ClubmakerCanFabra/casa_domotica/disseny_maqueta_casa/Distribució_Dispositius_Domotics_Casa.JPG

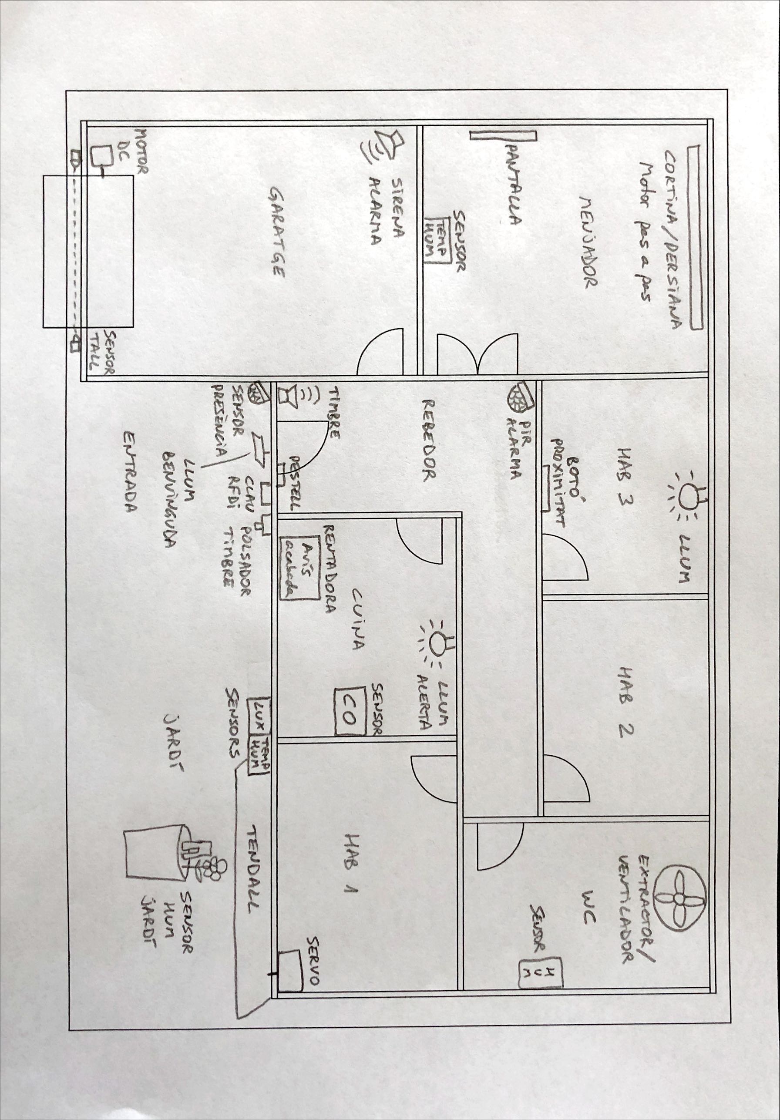
disseny_maqueta_casa/Distribució_Dispositius_Domotics_Casa.JPG
