ClubmakerCanFabra/casa_domotica/README.md

# casa_domotica
Casa domòtica amb Home Assistant Cursos 2022-2023, 2023-2024 i 2024-2025
American Space Club Maker Biblioteca Can Fabra
