ClubmakerCanFabra/casa_domotica/disseny_maqueta_casa/Electrònica/BME280 + Pantalla Oled.jpg

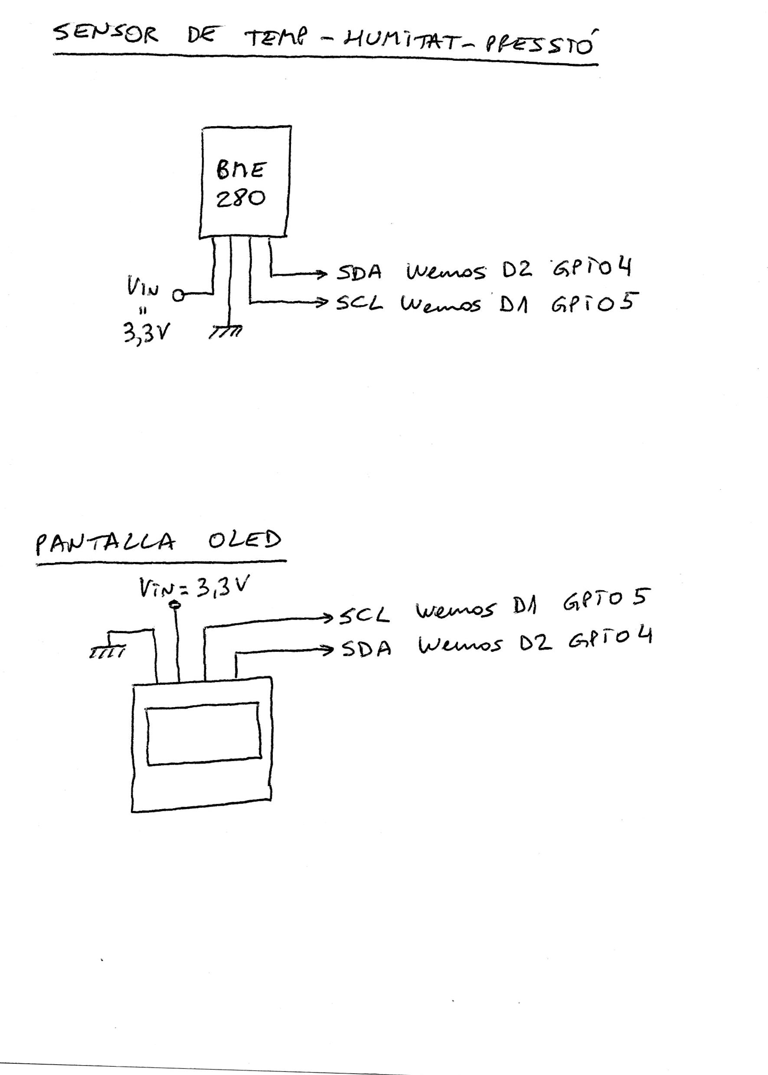
disseny_maqueta_casa/Electrònica/BME280 + Pantalla Oled.jpg
