ClubmakerCanFabra/casa_domotica/disseny_maqueta_casa/Electrònica/DHT.jpg

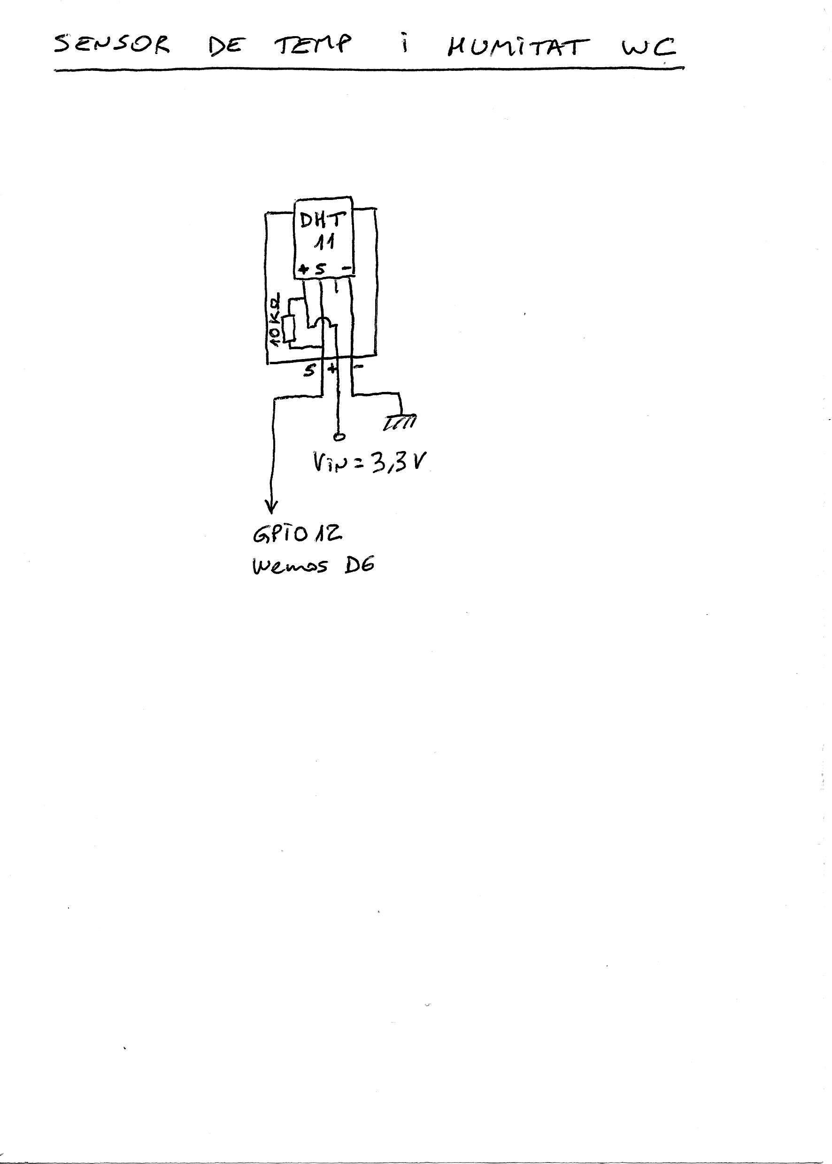
disseny_maqueta_casa/Electrònica/DHT.jpg
