ClubmakerCanFabra/casa_domotica/disseny_maqueta_casa/Electrònica/Llum + SensorCO + MesuraCorrent Cuina.jpg

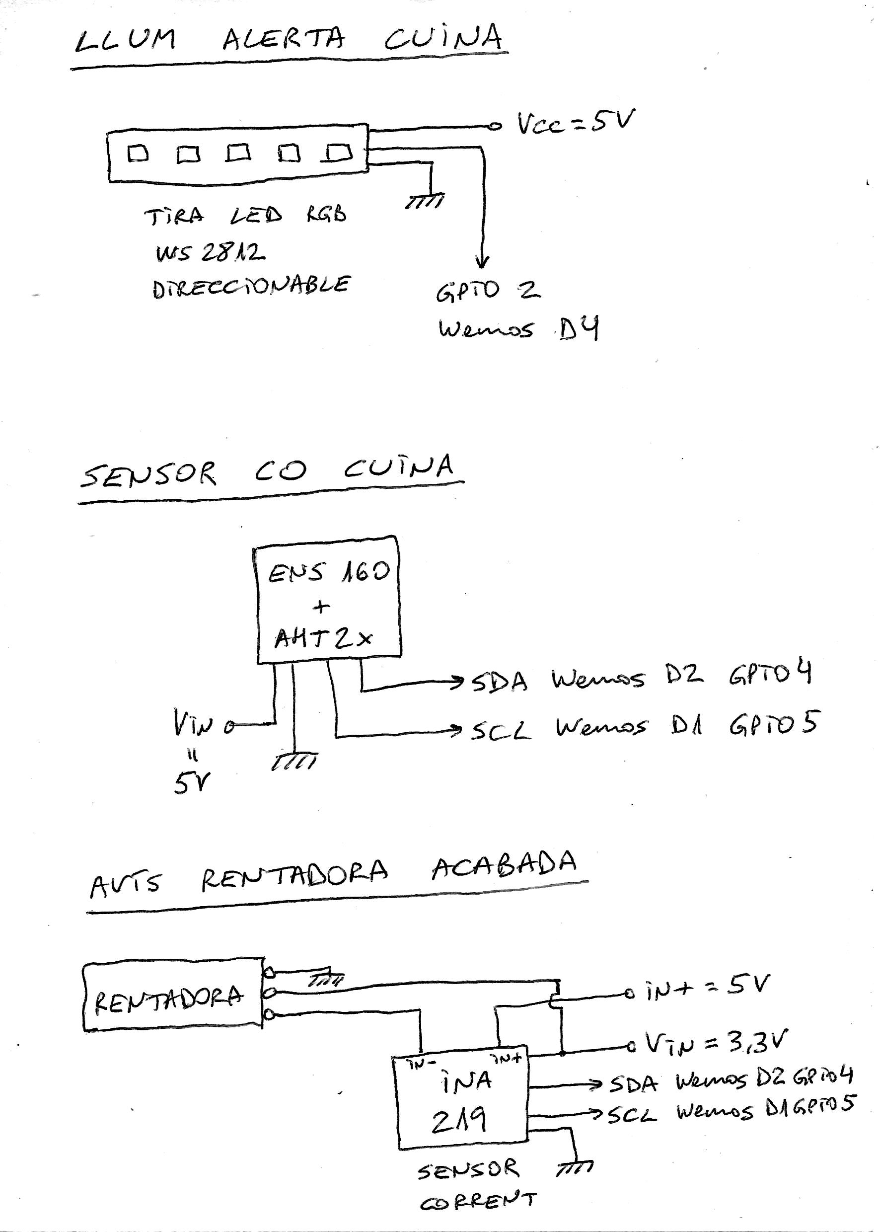
disseny_maqueta_casa/Electrònica/Llum + SensorCO + MesuraCorrent Cuina.jpg
