ClubmakerCanFabra/casa_domotica/disseny_maqueta_casa/Electrònica/Llum Habitació.jpg

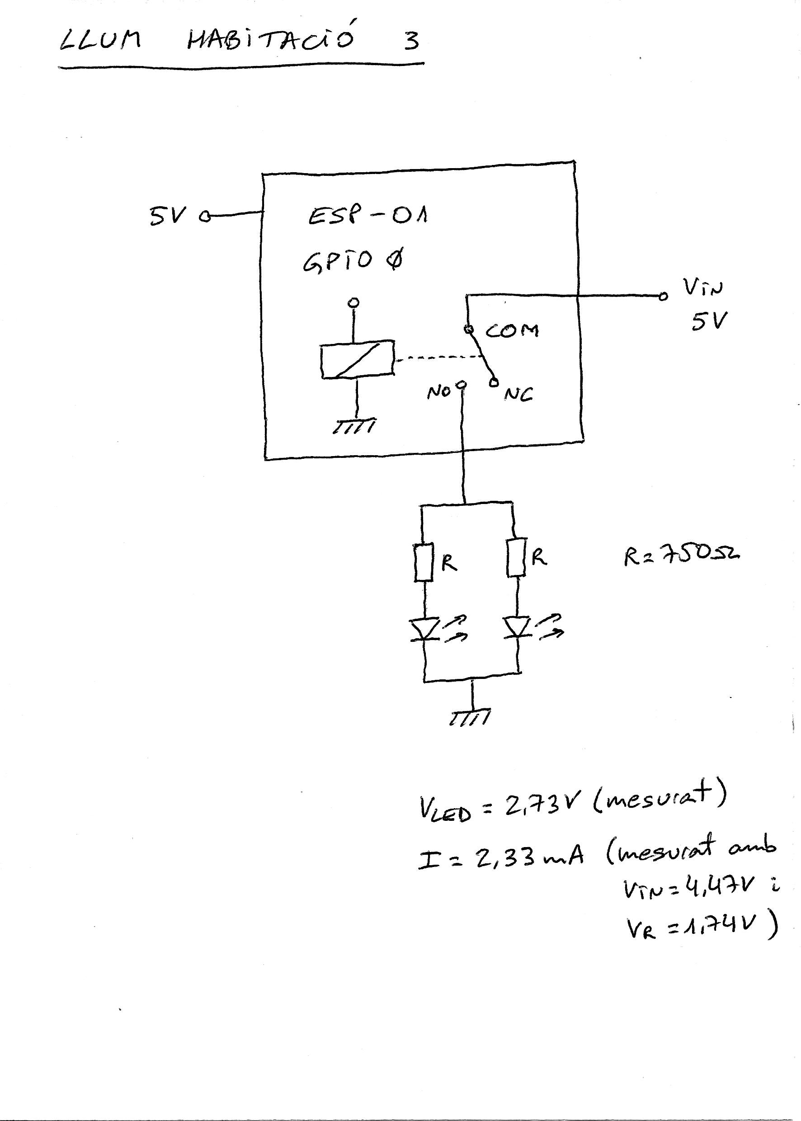
disseny_maqueta_casa/Electrònica/Llum Habitació.jpg
