ClubmakerCanFabra/casa_domotica/disseny_maqueta_casa/Electrònica/Rentadora.jpg

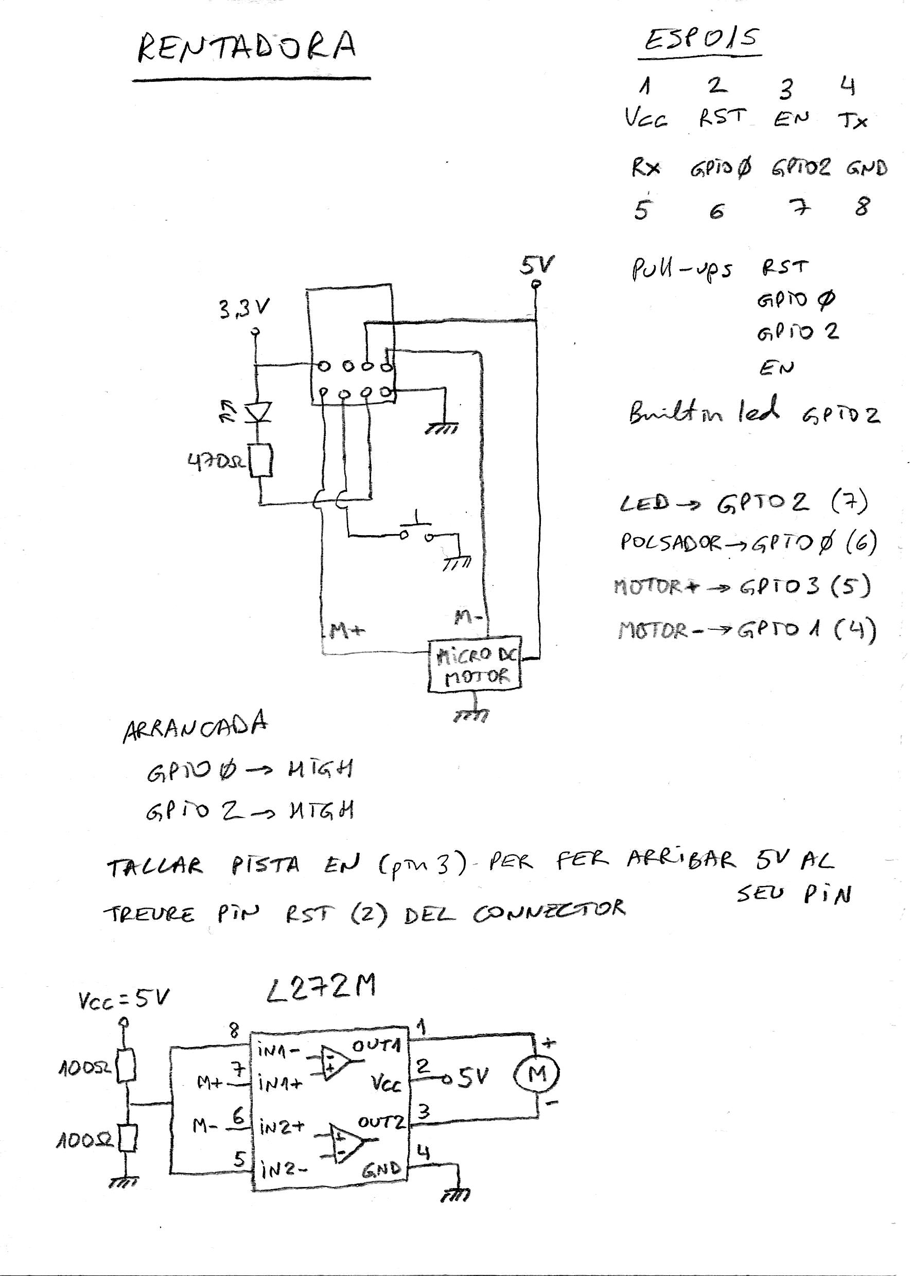
disseny_maqueta_casa/Electrònica/Rentadora.jpg
