ClubmakerCanFabra/casa_domotica/disseny_maqueta_casa/Electrònica/RFID+Polsador+PIR+Llum+Timbre.jpg

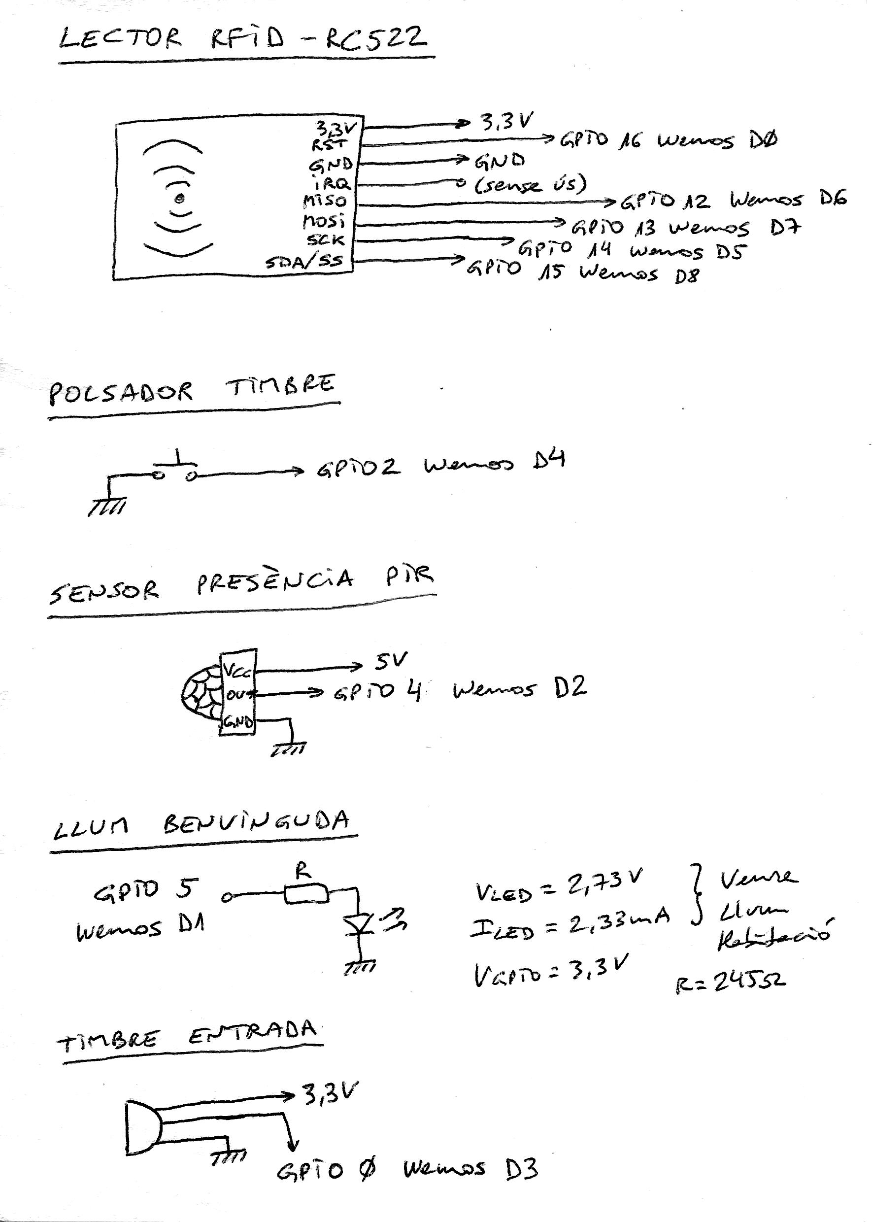
disseny_maqueta_casa/Electrònica/RFID+Polsador+PIR+Llum+Timbre.jpg
