ClubmakerCanFabra/casa_domotica/disseny_maqueta_casa/Electrònica/Sensor Tall Porta Garatge.jpg

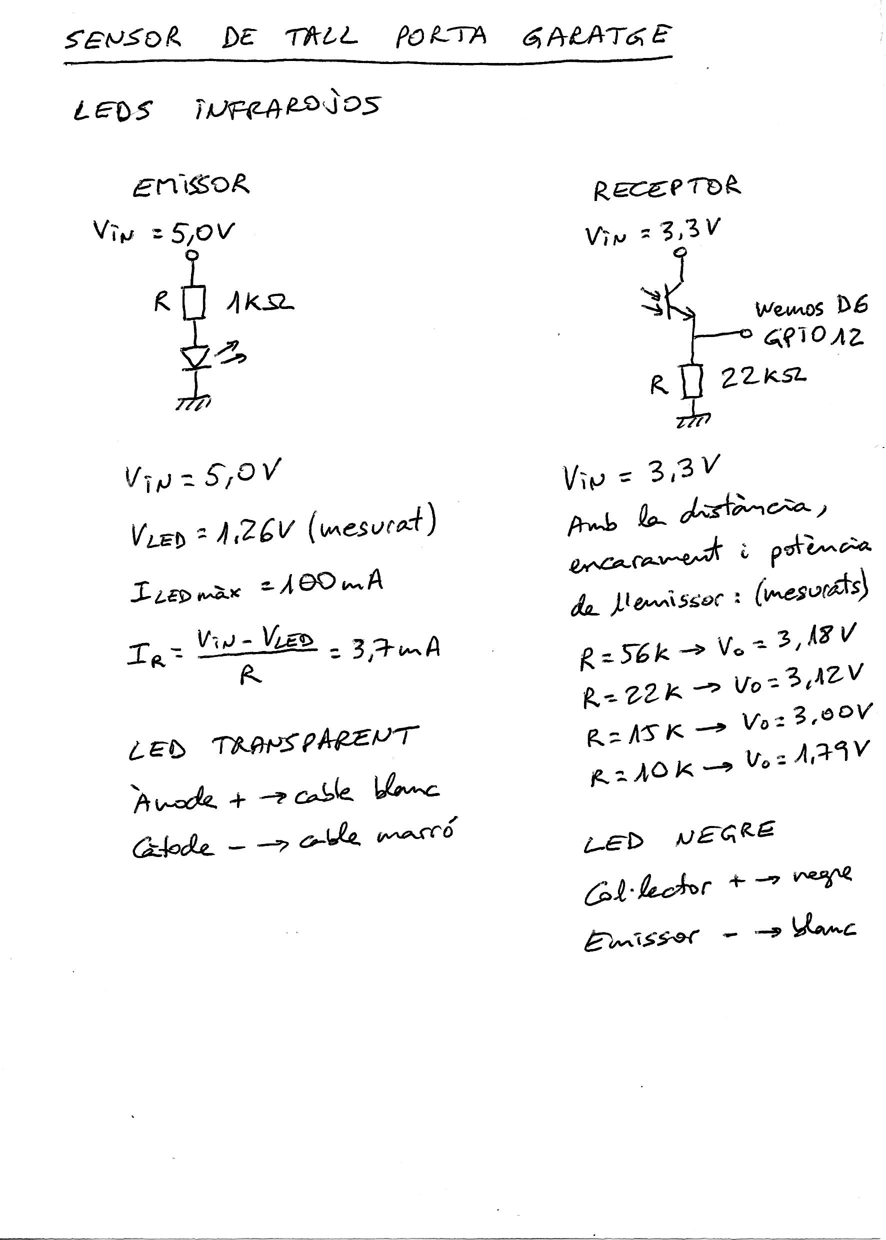
disseny_maqueta_casa/Electrònica/Sensor Tall Porta Garatge.jpg
