ClubmakerCanFabra/casa_domotica/disseny_maqueta_casa/Electrònica/Servo Porta Garatge.jpg

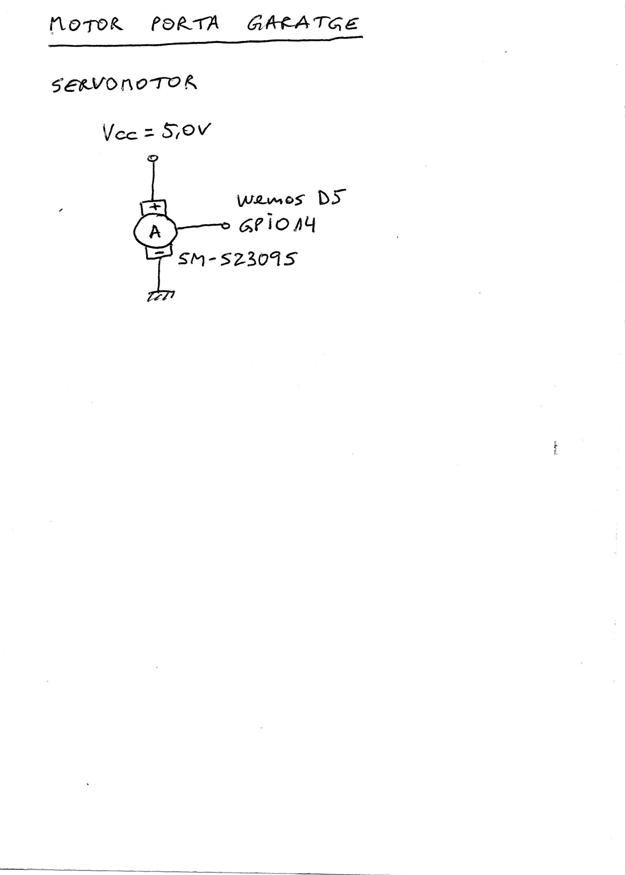
disseny_maqueta_casa/Electrònica/Servo Porta Garatge.jpg
