ClubmakerCanFabra/casa_domotica/disseny_maqueta_casa/Electrònica/Ventilador WC.jpg

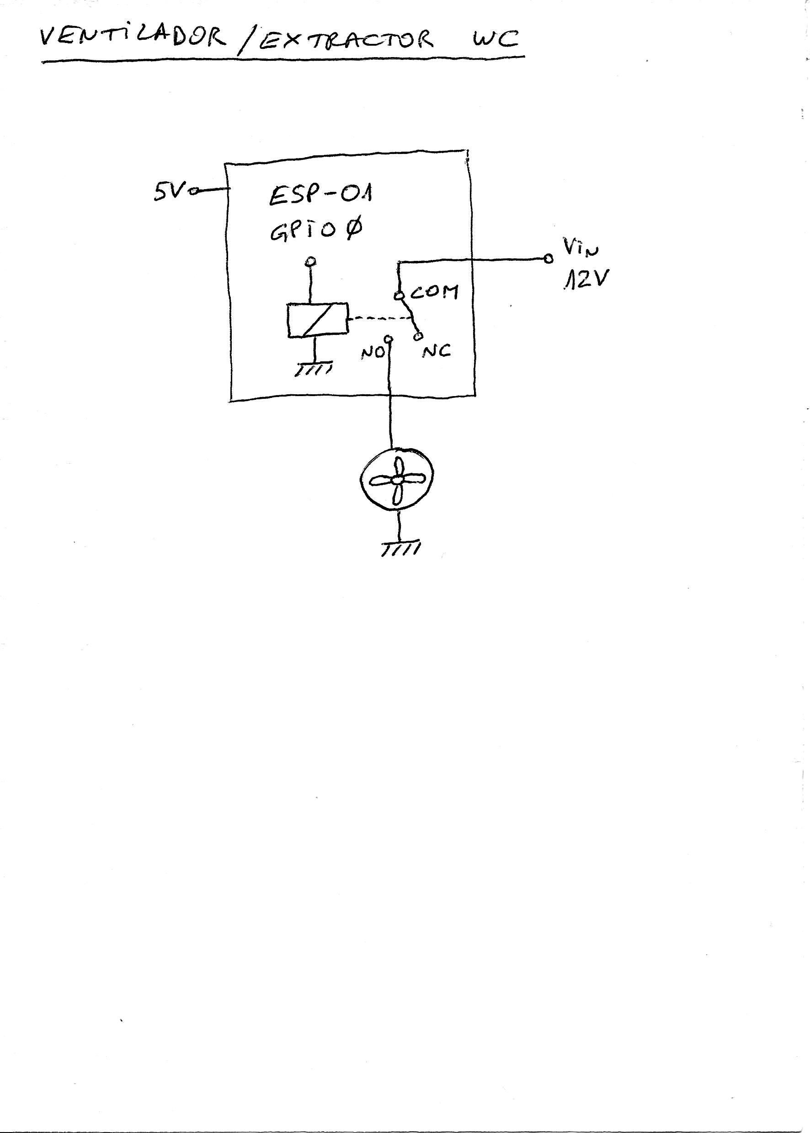
disseny_maqueta_casa/Electrònica/Ventilador WC.jpg
