ClubmakerCanFabra/casa_domotica/disseny_maqueta_casa/Electrònica/Voltímetre1.jpg

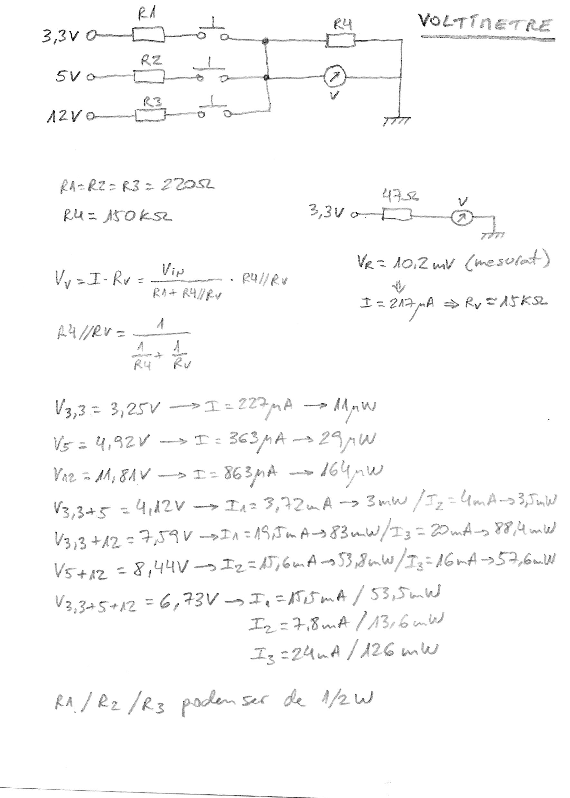
disseny_maqueta_casa/Electrònica/Voltímetre1.jpg
