ClubmakerCanFabra/casa_domotica/disseny_maqueta_casa/Electrònica/Voltímetre2.jpg

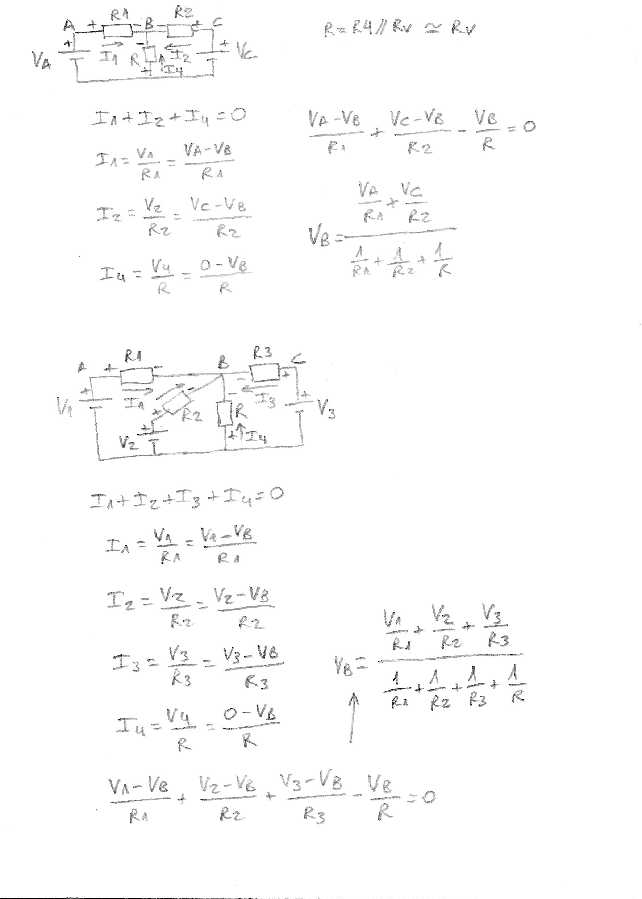
disseny_maqueta_casa/Electrònica/Voltímetre2.jpg
