ClubmakerCanFabra/casa_domotica/disseny_maqueta_casa/Elements 3D/Dissenys/Caixa ESP01 + Relé.jpg

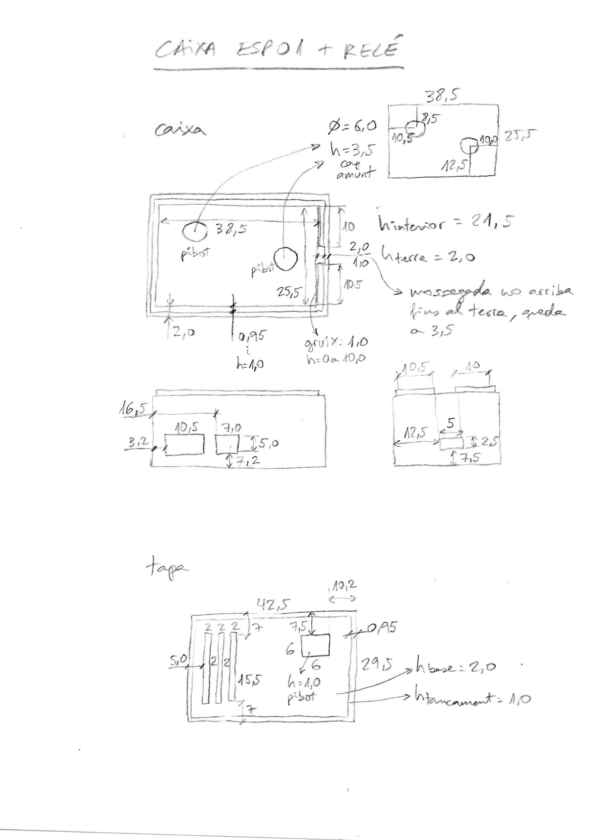
disseny_maqueta_casa/Elements 3D/Dissenys/Caixa ESP01 + Relé.jpg
