ClubmakerCanFabra/casa_domotica/disseny_maqueta_casa/Elements 3D/Dissenys/Caixa SensorCO.jpg

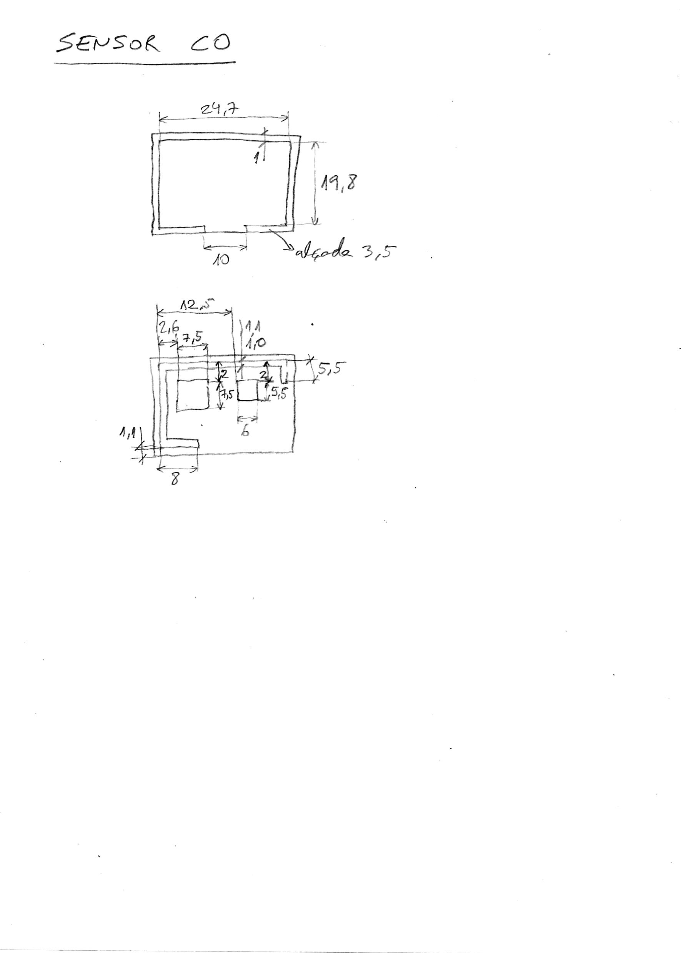
disseny_maqueta_casa/Elements 3D/Dissenys/Caixa SensorCO.jpg
