ClubmakerCanFabra/casa_domotica/disseny_maqueta_casa/Elements 3D/Dissenys/Caixa Wemos.jpg

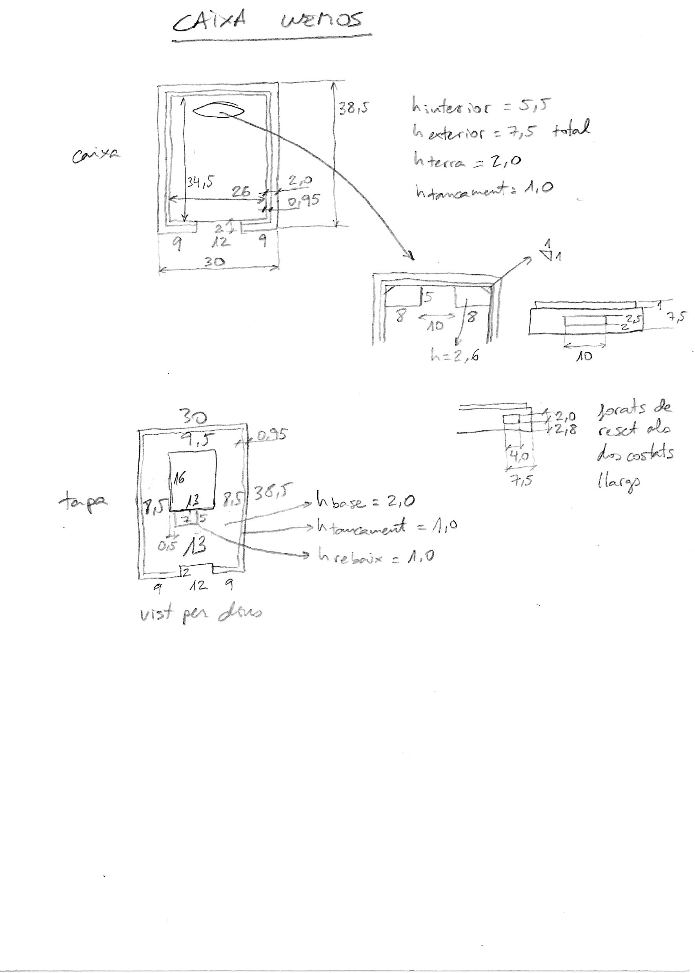
disseny_maqueta_casa/Elements 3D/Dissenys/Caixa Wemos.jpg
