ClubmakerCanFabra/casa_domotica/disseny_maqueta_casa/Elements 3D/Dissenys/Caixes BME280 + Pantalla Oled.jpg

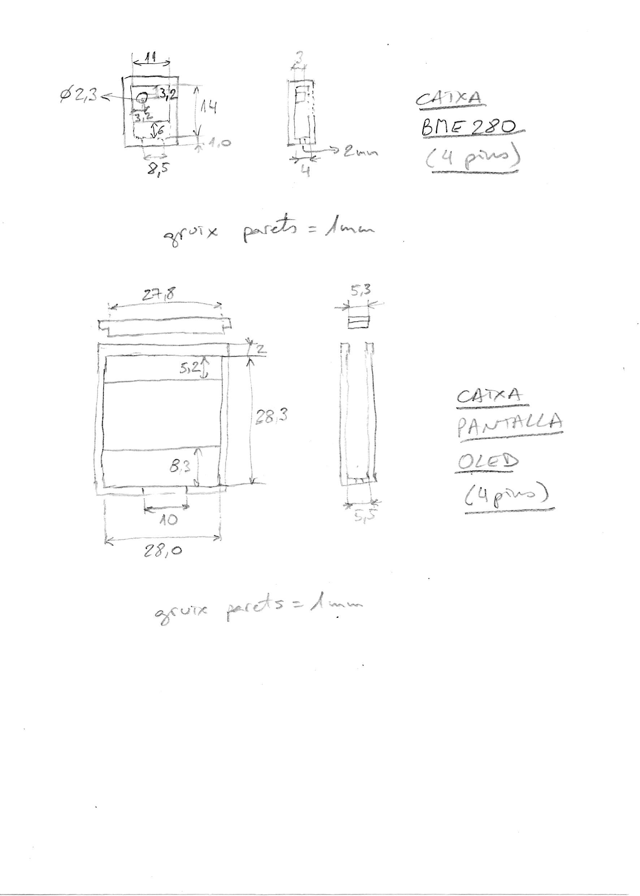
disseny_maqueta_casa/Elements 3D/Dissenys/Caixes BME280 + Pantalla Oled.jpg
