ClubmakerCanFabra/casa_domotica/disseny_maqueta_casa/Elements 3D/Dissenys/Caixes Ventilador + Col·lector.jpg

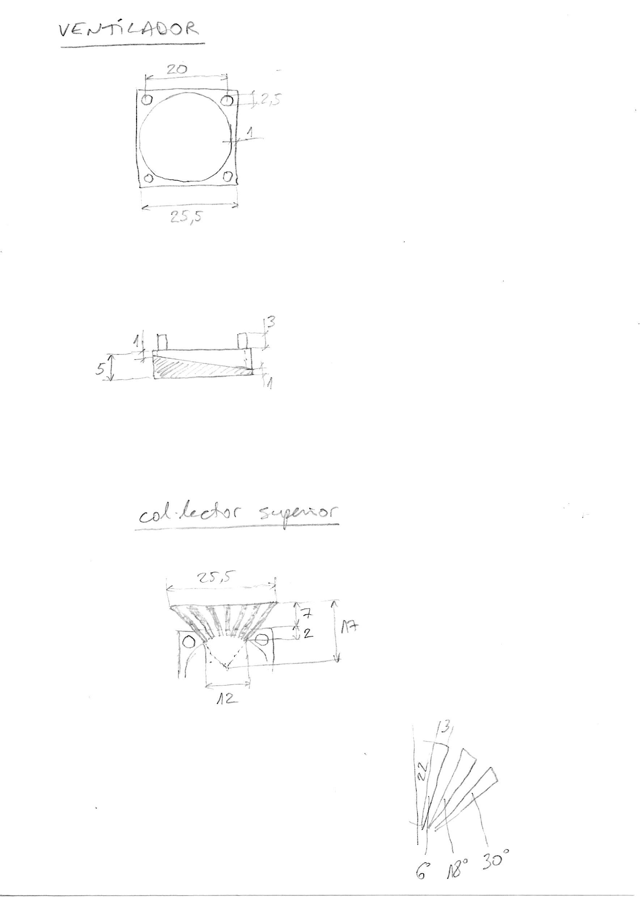
disseny_maqueta_casa/Elements 3D/Dissenys/Caixes Ventilador + Col·lector.jpg
