ClubmakerCanFabra/casa_domotica/disseny_maqueta_casa/Elements 3D/Dissenys/Ferratge Saxo Porta Pk.jpg

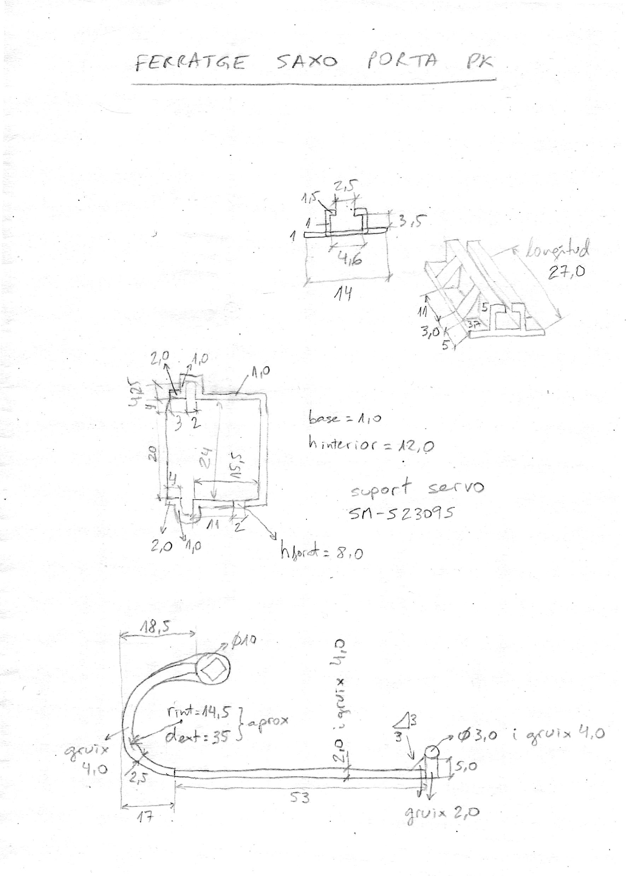
disseny_maqueta_casa/Elements 3D/Dissenys/Ferratge Saxo Porta Pk.jpg
