ClubmakerCanFabra/casa_domotica/disseny_maqueta_casa/Material_Projecte_HAss_CM.xlsx

Sheet: Material
MATERIAL PROJECTE HOME ASSISTANT CLUB MAKER
Estança | Dispositius | Material | Control |  |  | TENIM
GARATGE | Motor porta | Servo DC amb reductora | Wemos | * | 3 | Wemos | * | +6
 | Sensor tall porta | Sensor Tx-Rx infrarojos |  | * | 2 | Pir | *
 | Sirena alarma | Bronzidor | Placa relé + ESP-01 |  | 2 | bronzidor passiu | *
ENTRADA | Sensor presència | HC-SR501 | Wemos |  | 1 | pantalla | *
 | Llum benvinguda | Led blanc + R1K | Placa relé + ESP-01 |  | 1 | bme680 (qualitat aire) | *
 | Polsador timbre | Polsador | (Wemos) |  | 2 | bme280 | * | +1
 | Clau porta | Rfdi | (Wemos) |  | 1 | rfid amb clau | *
REBEDOR | Timbre entrada | Bronzidor | Placa relé + ESP-01 |  | 2 | led blanc (benvinguda) | *
 | Pestell | Servo | Placa relé + ESP-01 |  | 1 | polsador | *
 | Sensor volumètric alarma | HC-SR501 | Wemos |  | 1 | Sensor humitat jardí | *
 | Sensor magnètic porta alarma | MC-38 |  | * | 1 | servo | * | +1
MENJADOR | Motor pas a pas persiana | ULN2003 28BYJ-48 |  | * | 1 | tira neopixel | *
 | Pantalla | Oled | Wemos |  | 0 | sensor llum |  | +1
 | Sensor Temp/Hum interior | BME280 | (Wemos) |  | 0 | ventilador |  | +1
CUINA | Sensor CO | CCS811 / bme680 | Wemos |  | 0 | Placa relé + ESP-01 |  | +6
 | Llum alerta | Tira Neopíxels | (Wemos)
 | Avís Rentadora acabada
HABITACIÓ 3 | Botó proximitat | paper plata + R1M | Wemos
 | Llum | Led blanc + R1K | Placa relé + ESP-01
WC | Sensor Temp/Hum | DHT11 | Wemos | *
 | Extractor aire | Ventilador 4x4cm 5V | Placa relé + ESP-01 | *
HABITACIÓ 1 | Servo tendall | SG90
JARDÍ | Sensor Temp/Hum exterior | BME280 | Wemos
 | Sensor llum/sol | TSL2561 | (Wemos)
 | Sensor humitat jardí |  | (Wemos)

Sheet: Compres
Descripció | Link Aliexpress | Preu
WeMos D1 Mini V3.0 microUSB | https://es.aliexpress.com/item/32831353752.html?mp=1 | 1.94 €
Sensor de luz infrarroja TSL2561 | https://www.aliexpress.com/item/4000875271177.html?spm=a2g0o.cart.0.0.11b27a9dQup9MQ&mp=1 | 3.23 €
Módulo de relé ESP8266 + ESP-01 | https://es.aliexpress.com/item/32833583868.html?mp=1 | 1.84 €
Emisor y receptor IR 301A 5mm, 940nm led, 10 pares | https://es.aliexpress.com/item/32693354491.html?mp=1 | 0.61 €
Ventilador 12V 25x25mm 2510 | https://es.aliexpress.com/item/1005002448626904.html?mp=1 | 1.41 €
Luz entrada casa type1 10 unidades | https://es.aliexpress.com/item/1005003422885437.html?mp=1 | 0.98 €
Foco led 3V 12 unidades | https://es.aliexpress.com/item/1005004987442239.html?mp=1 | 3.22 €
Farola tren 10 unidades | https://es.aliexpress.com/item/4001227697309.html?mp=1 | 0.98 €

Sheet: Wemos
 |  |  | https://www.luisllamas.es/wemos-d1-mini-una-genial-placa-de-desarrollo-con-esp8266/
Pin | ESP-8266 Pin | Función
TX | TXD | TXD
RX | RXD | RXD
A0 | A0 | Analog input (max 3.2V)
D0 | GPIO16 | IO
D1 | GPIO5 | IO, PWM, Interrupt, I2C, SCL
D2 | GPIO4 | IO, PWM, Interrupt, I2C, SDA
D3 | GPIO0 | IO 10k Pull-up, PWM, Interrupt, I2C
D4 | GPIO2 | IO 10k Pull-up, PWM, Interrupt, I2C, BUILTIN_LED
D5 | GPIO14 | IO, PWM, Interrupt, I2C, SCK
D6 | GPIO12 | IO, PWM, Interrupt, I2C,, MISO
D7 | GPIO13 | IO, PWM, Interrupt, I2C,, MOSI
D8 | GPIO15 | IO 10k Pull-down, PWM, Interrupt, I2C,, SS
G | GND | Ground
5V | - | 5V
3V3 | 3.3V | 3.3V
RST | RST | Reset
