ClubmakerCanFabra/casa_domotica/disseny_maqueta_casa/Elements 3D/Stl/Caixa Wemos.stl

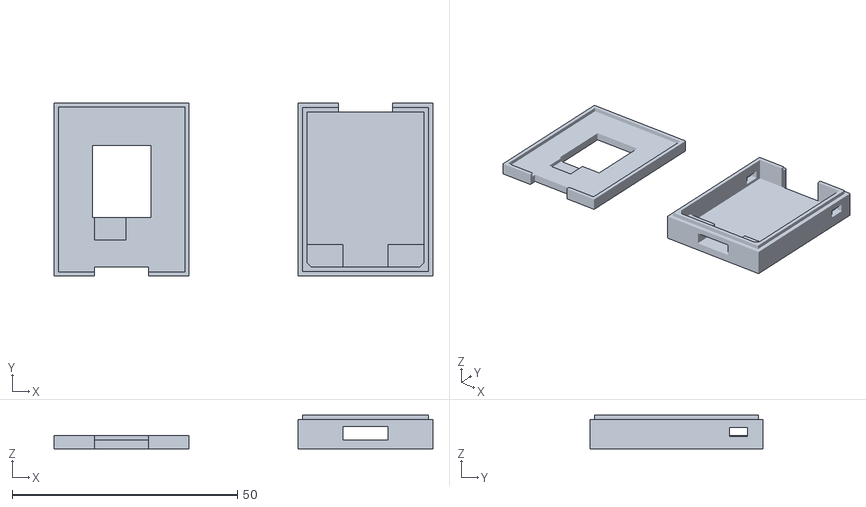
[picture p53: CAD file, 2025-03-27]
disseny_maqueta_casa/Elements 3D/Stl/Caixa Wemos.stl
84.1 x 38.5 x 7.50
