ClubmakerCanFabra/casa_domotica/disseny_maqueta_casa/Plotejat/Acad/AmericanSpace logo vectoritzat InkScape.dxf

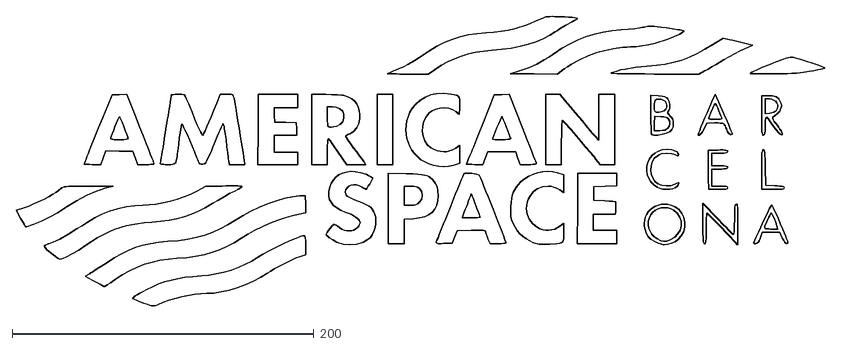
[picture p54: CAD file, 2025-03-27]
disseny_maqueta_casa/Plotejat/Acad/AmericanSpace logo vectoritzat InkScape.dxf
536.6 x 192.5
