ClubmakerCanFabra/casa_domotica/disseny_maqueta_casa/Elements 3D/Stl/Caixa Lector RFID.stl

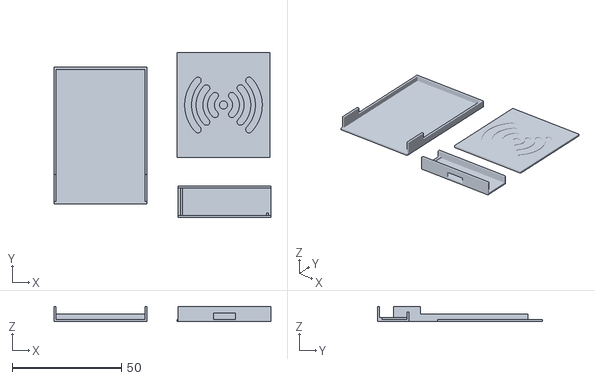
[picture p56: CAD file, 2025-03-27]
disseny_maqueta_casa/Elements 3D/Stl/Caixa Lector RFID.stl
99.2 x 75.4 x 7.00
