ClubmakerCanFabra/casa_domotica/disseny_maqueta_casa/Elements 3D/Stl/Caixa Polsador Timbre.stl

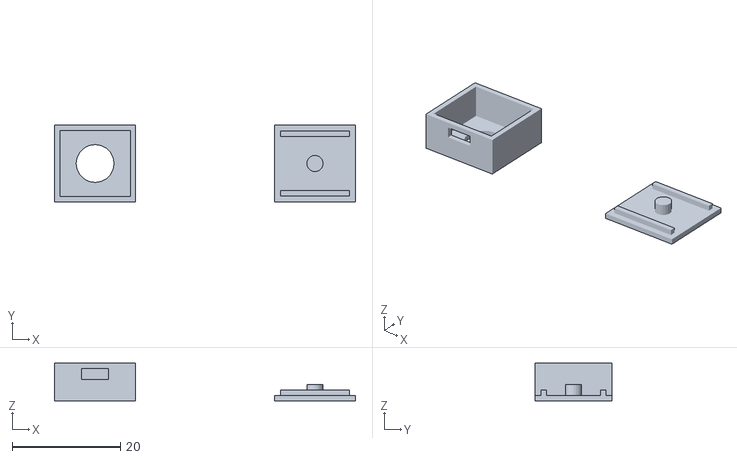
[picture p58: CAD file, 2025-03-27]
disseny_maqueta_casa/Elements 3D/Stl/Caixa Polsador Timbre.stl
55.6 x 14.2 x 7.00
