ClubmakerCanFabra/casa_domotica/disseny_maqueta_casa/Plotejat/dxf/Casa Home Assistant 2de3.dxf

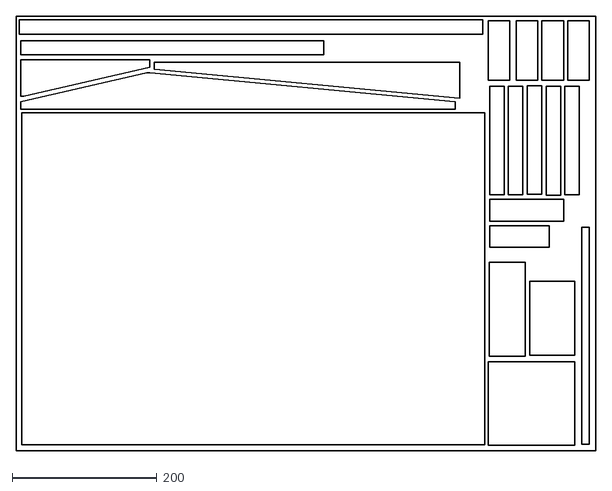
[picture p59: CAD file, 2022-12-01]
disseny_maqueta_casa/Plotejat/dxf/Casa Home Assistant 2de3.dxf
800.0 x 600.0
