ClubmakerCanFabra/casa_domotica/disseny_maqueta_casa/Elements 3D/Stl/Caixa Rentadora.stl

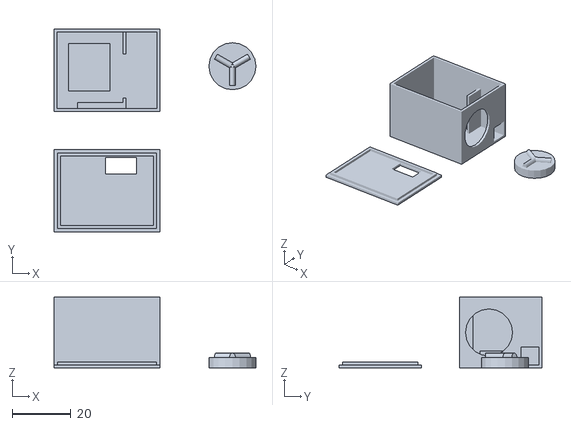
[picture p60: CAD file, 2025-03-27]
disseny_maqueta_casa/Elements 3D/Stl/Caixa Rentadora.stl
68.6 x 69.0 x 24.0
