ClubmakerCanFabra/casa_domotica/disseny_maqueta_casa/Elements 3D/Stl/Caixa Voltímetre.stl

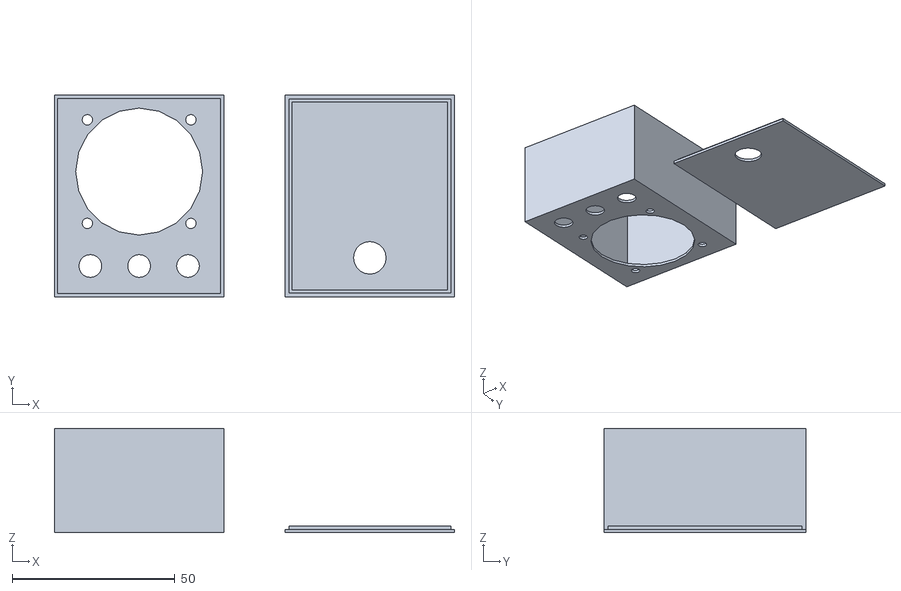
[picture p61: CAD file, 2025-03-27]
disseny_maqueta_casa/Elements 3D/Stl/Caixa Voltímetre.stl
122.9 x 62.0 x 32.0
