ClubmakerCanFabra/casa_domotica/disseny_maqueta_casa/Elements 3D/Stl/Caixa Pantalla Oled (4 pins).stl

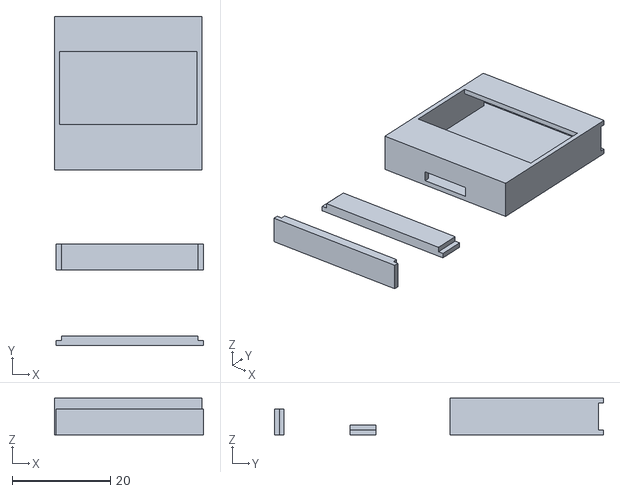
[picture p62: CAD file, 2025-03-27]
disseny_maqueta_casa/Elements 3D/Stl/Caixa Pantalla Oled (4 pins).stl
30.3 x 67.0 x 7.50
