ClubmakerCanFabra/casa_domotica/disseny_maqueta_casa/Elements 3D/Stl/Caixa PIR.stl

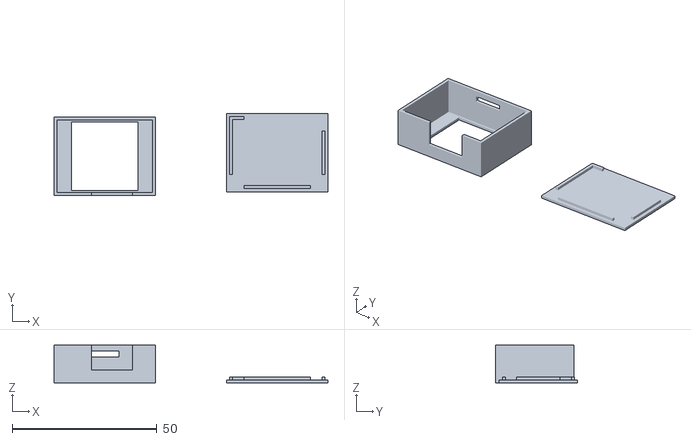
[picture p63: CAD file, 2025-03-27]
disseny_maqueta_casa/Elements 3D/Stl/Caixa PIR.stl
94.5 x 28.2 x 13.0
