ClubmakerCanFabra/casa_domotica/disseny_maqueta_casa/Elements 3D/Stl/Caixa Sensor CO.stl

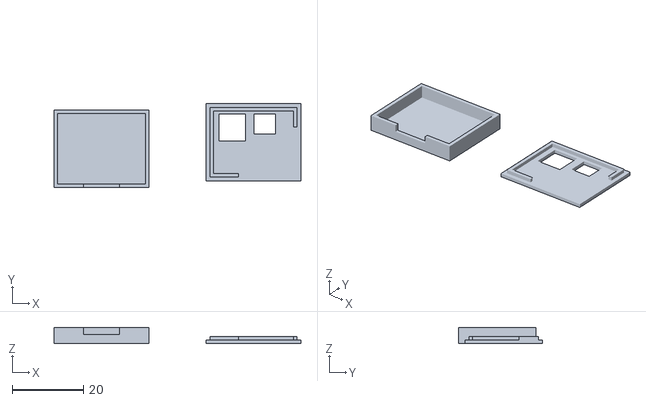
[picture p64: CAD file, 2025-03-27]
disseny_maqueta_casa/Elements 3D/Stl/Caixa Sensor CO.stl
69.4 x 23.6 x 4.50
