ClubmakerCanFabra/casa_domotica/disseny_maqueta_casa/Elements 3D/Stl/Caixa Sensor Corrent.stl

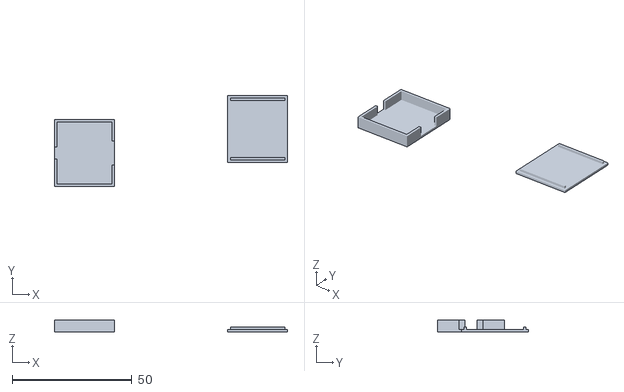
[picture p65: CAD file, 2025-03-27]
disseny_maqueta_casa/Elements 3D/Stl/Caixa Sensor Corrent.stl
97.4 x 38.1 x 5.00
