ClubmakerCanFabra/casa_domotica/disseny_maqueta_casa/Elements 3D/Stl/Obertura porta pk Casa Domòtica.stl

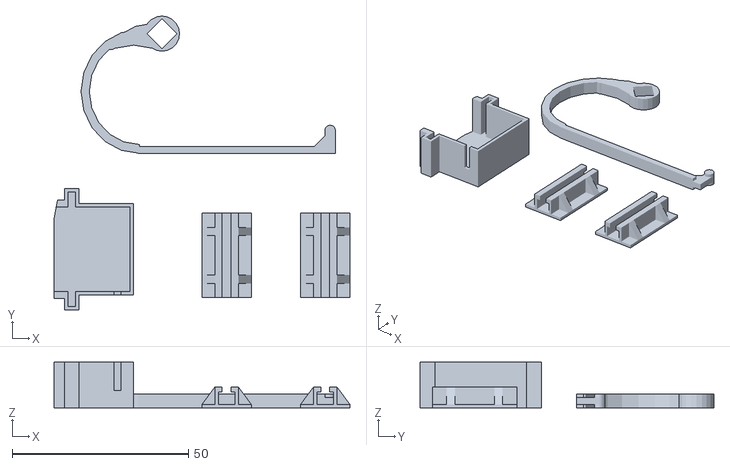
[picture p66: CAD file, 2025-03-27]
disseny_maqueta_casa/Elements 3D/Stl/Obertura porta pk Casa Domòtica.stl
84.0 x 83.5 x 13.0
