ClubmakerCanFabra/casa_domotica/disseny_maqueta_casa/Elements 3D/Stl/Caixa BME280 (4 pins).stl

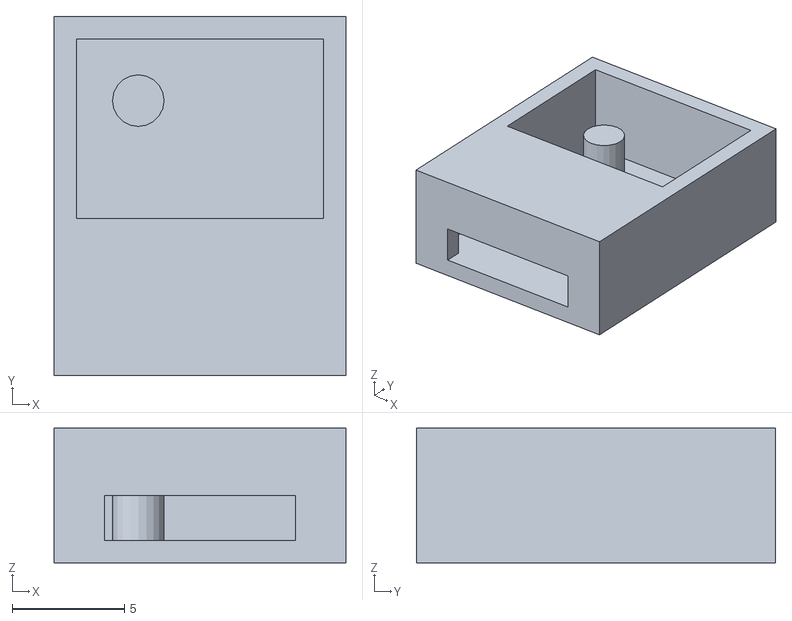
[picture p67: CAD file, 2025-03-27]
disseny_maqueta_casa/Elements 3D/Stl/Caixa BME280 (4 pins).stl
13.0 x 16.0 x 6.00
