ClubmakerCanFabra/casa_domotica/disseny_maqueta_casa/Elements 3D/Stl/Caixa Relé ESP01.stl

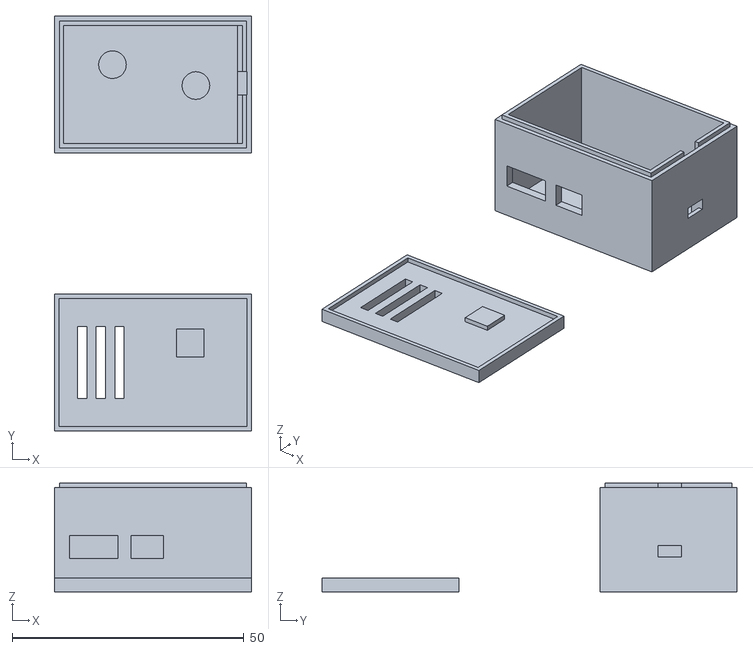
[picture p68: CAD file, 2025-03-27]
disseny_maqueta_casa/Elements 3D/Stl/Caixa Relé ESP01.stl
42.5 x 89.5 x 23.5
