ClubmakerCanFabra/casa_domotica/disseny_maqueta_casa/Elements 3D/Stl/Caixa Ventilador-Col·lector.stl

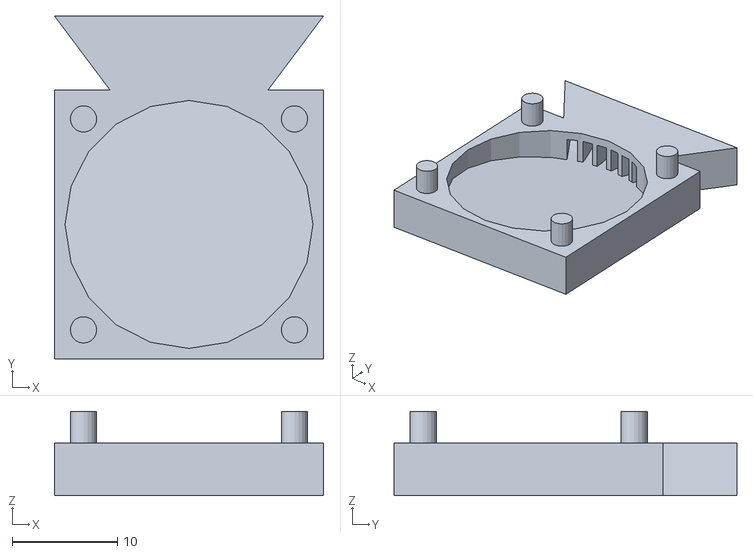
[picture p69: CAD file, 2025-03-27]
disseny_maqueta_casa/Elements 3D/Stl/Caixa Ventilador-Col·lector.stl
25.5 x 32.5 x 8.00
