ClubmakerCanFabra/casa_domotica/disseny_maqueta_casa/Elements 3D/Stl/Guies porta pk Casa Domòtica HA.stl

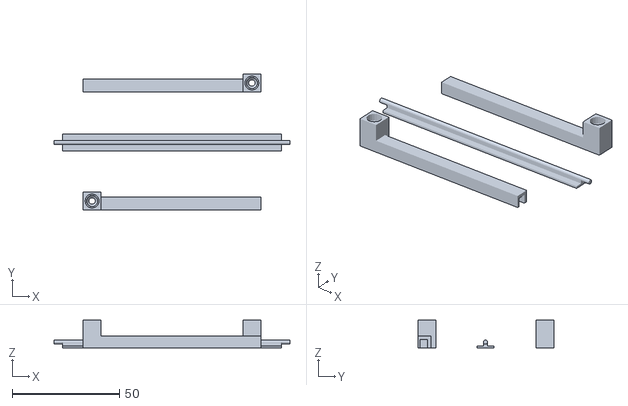
[picture p70: CAD file, 2022-12-10]
disseny_maqueta_casa/Elements 3D/Stl/Guies porta pk Casa Domòtica HA.stl
110.0 x 63.5 x 13.0
