ClubmakerCanFabra/casa_domotica/(list of files, cad)

Other CAD files:
disseny_maqueta_casa/Plotejat/Acad/Autocad block files/block.dwg
disseny_maqueta_casa/Plotejat/Acad/AmericanSpace logo vectoritzat.dwg
disseny_maqueta_casa/Plotejat/Acad/Gravat logo-text vectoritzats.dwg
disseny_maqueta_casa/Plotejat/Acad/Casa Home Assistant distribuïda.dwg
disseny_maqueta_casa/Plotejat/Acad/Casa Home Assistant Planta.dwg
