ClubmakerCanFabra/casa_domotica/disseny_maqueta_casa/Plotejat/pdf/Casa Home Assistant Planta.pdf

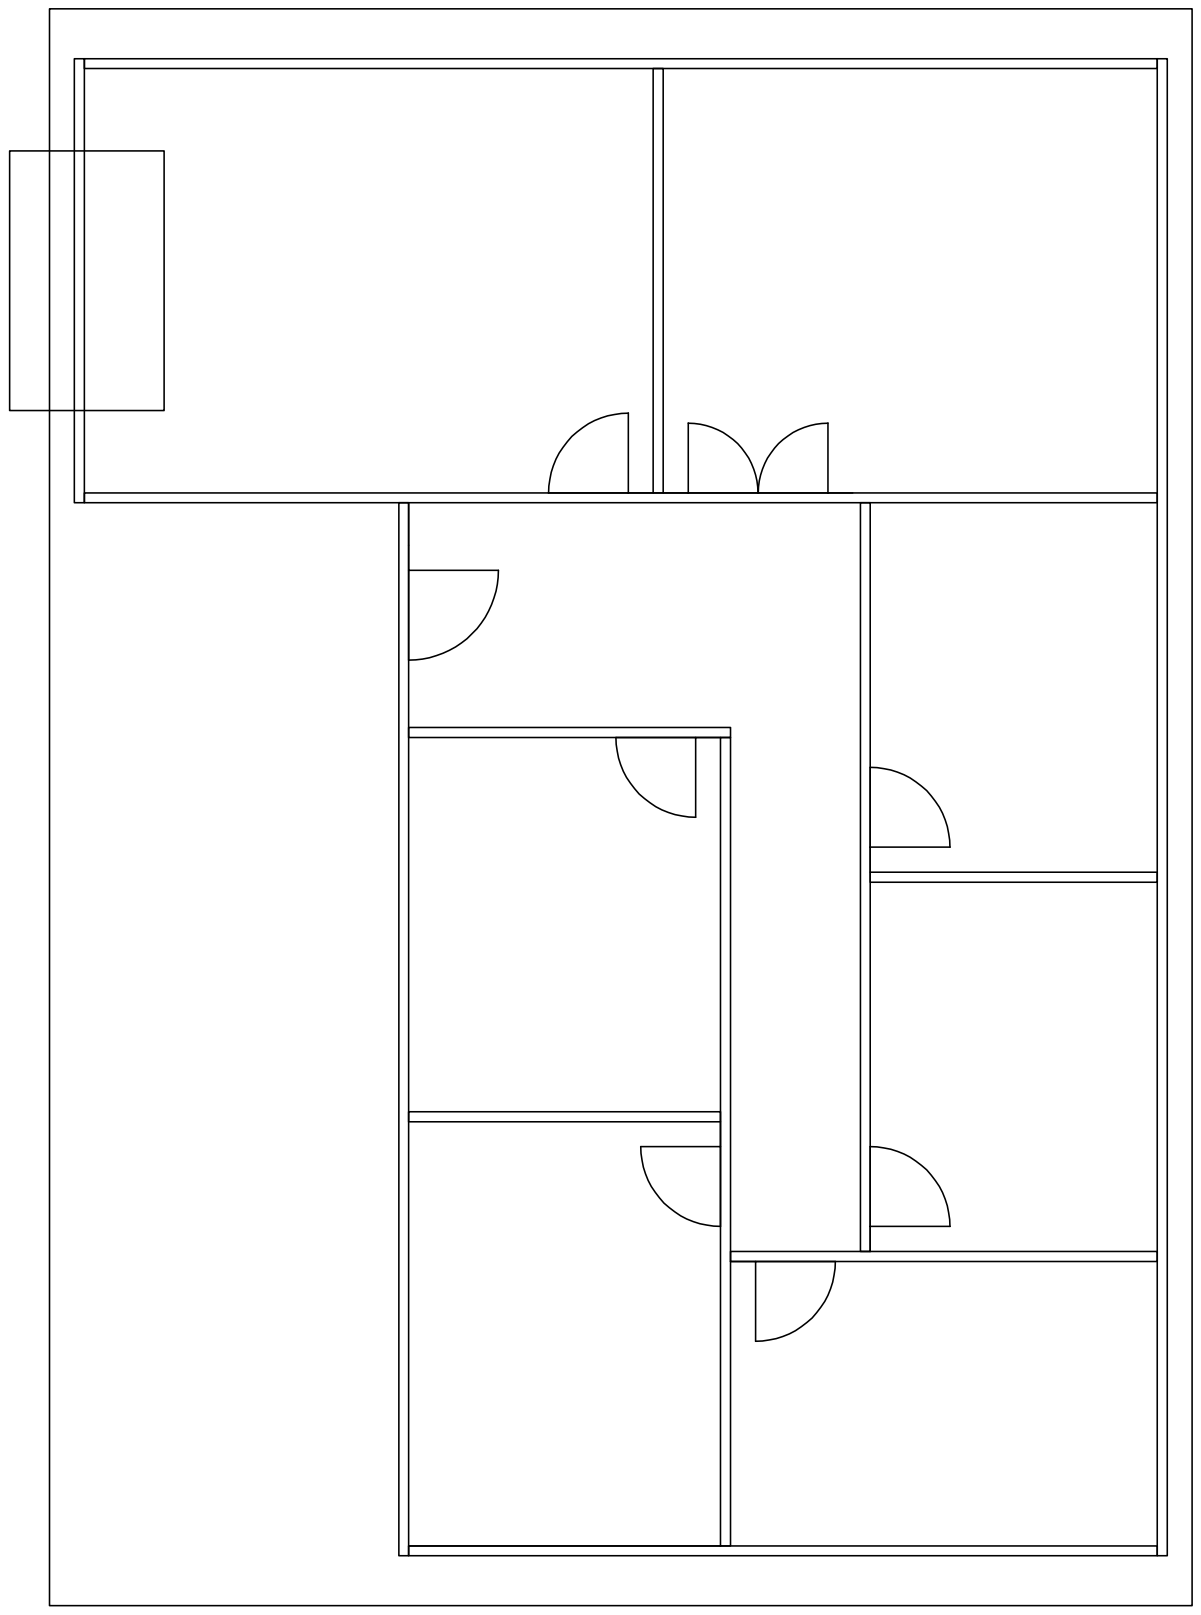
[picture p71: page 1]
