ClubmakerCanFabra/casa_domotica/disseny_maqueta_casa/Plotejat/pdf/Gravat logo-text vectoritzats.pdf

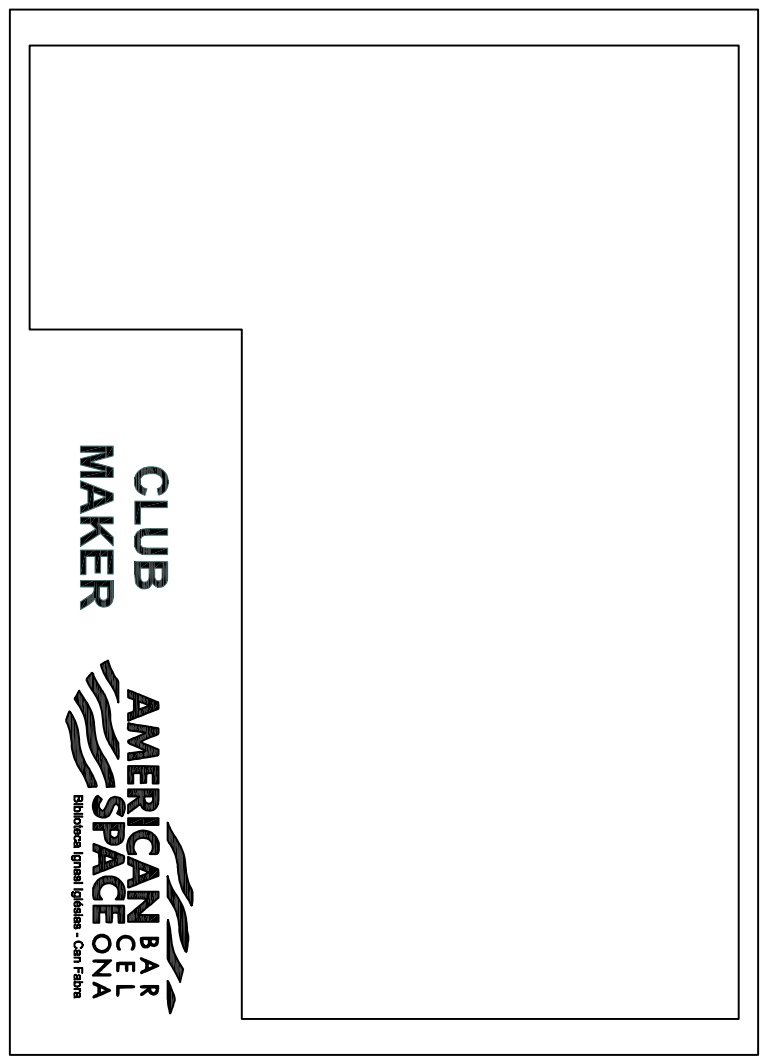
[picture p72: page 1]
