ClubmakerCanFabra/casa_domotica/(commit log)

2022-12-01 Fitxers dxf per maqueta casa
    Fitxers dxf per tallar fustes de 4mm de gruix i gravar el logo
2022-12-01 Material domòtica Home Assistant
    [Material_Projecte_HAss_CM.xlsx]
2022-12-01 Fitxers dxf maqueta casa
    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
    [Casa Home Assistant 1de3.dxf, Casa Home Assistant 2de3.dxf, Casa Home Assistant 3de3.dxf]
2022-12-04 Delete disseny_maqueta_casa directory
    canviats noms i afegits fitxers
    [Casa Home Assistant 1de3.dxf, Casa Home Assistant 2de3.dxf, Casa Home Assistant 3de3.dxf]
2022-12-04 Delete disseny_maqueta_casa directory
    oblidat de posar-li nom
    [Casa_Home_Assistant_1de3.dxf, Casa_Home_Assistant_2de3.dxf, Casa_Home_Assistant_3de3.dxf]
2022-12-04 Fitxers disseny maqueta
    Fitxers dxf i pdf per realitzar el tall làser de les fustes de 4mm de gruix
    [Casa_Home_Assistant_1de3.dxf, Casa_Home_Assistant_2de3.dxf, Casa_Home_Assistant_3de3.dxf]
2022-12-05 Distribució i llistat dispositius domòtics
    [Material_Projecte_HAss_CM.xlsx]
2022-12-06 Material projectes Club Maker
    Llista de material amb links a Aliexpress per comprar
2022-12-06 Stl per impressió 3D
    Dues guies laterals i el corró central per articular el moviment de la porta del pk
    [Guies porta pk Casa Domòtica HA.stl]
